N3MI-DG/StealthChanger/UserMods/N3MI-DG/SC_Barf/README.md

# Stealthchanger Barf

PCB with 1.5mm RGB leds arranged into the StealthChanger logo pattern.

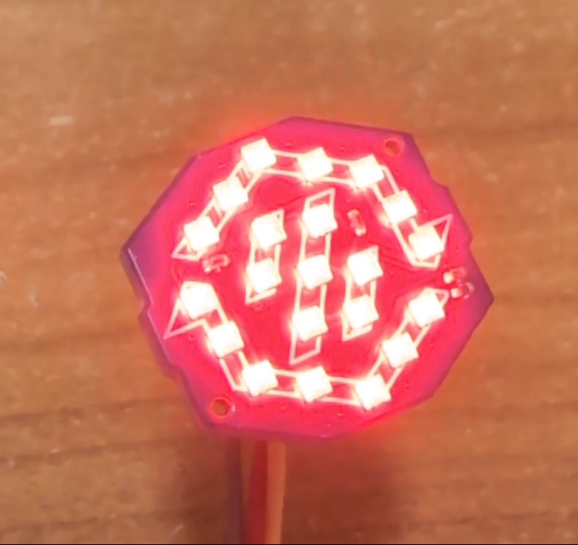
[picture p1: UserMods/N3MI-DG/SC_Barf/images/1.png]



## Example Config

```text
[neopixel rgb_logo]
pin: PB3
color_order: GRB
chain_count: 21
initial_RED: 0.3
initial_BLUE: 0.0
initial_GREEN: 0.3
```

## How to Order from JLCPCB

- Add Gerbers `Gerbers.zip`
- Select the PCB qty you want
- Select the PCB color you want
- Select `Order Number(Specify Position)`
- Enable PCB Assembly
- Select `Added by Customer` in the Tooling holes section
- Press the `Next` button
- Press the next `Next` button
- Add BOM file `BOM-JLC.csv`
- Add CPL file `CPL-JLC.csv`
- Click the `Process BOM & CPL` button
- Make sure the selected componants are correct
- Click the `Next` button
- Confirm componant placement
- Click the `Next` button
- Save to cart & checkout.

Note. there is an alternative RGB led componant that can be selected if the `SK6805-EC15` is out of stock. `DY-S1515065/RGBC/6805-5T` by TONYU is 1:1 compatible but the JLC footprint is rotated 180 degrees. Confirm you have the correct orientations.

### SK6805-EC15
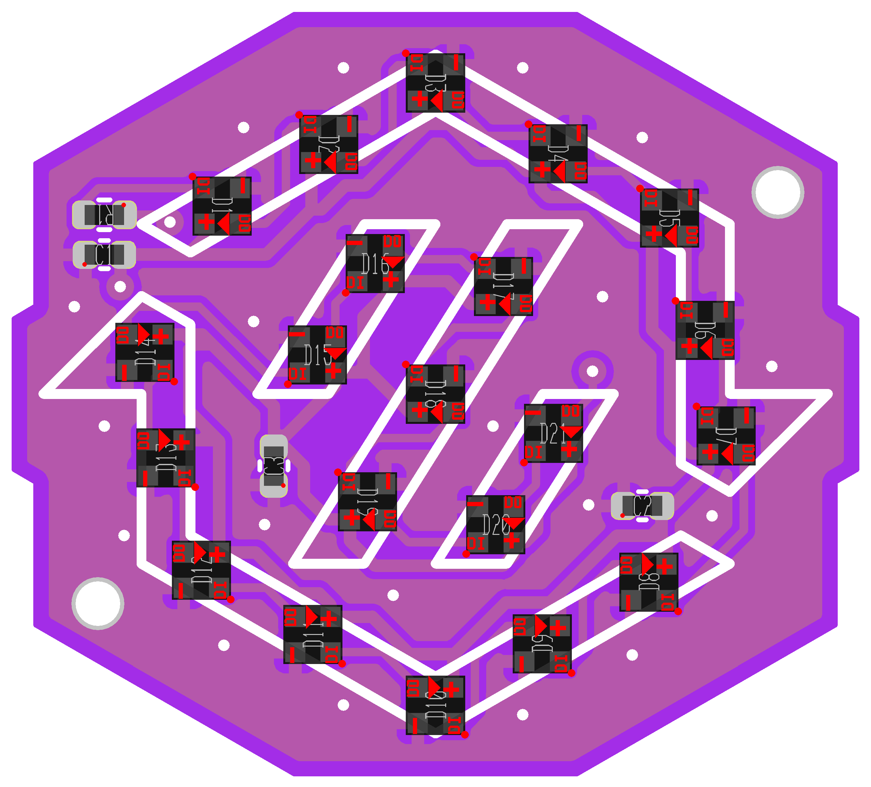
[picture p2: UserMods/N3MI-DG/SC_Barf/images/corrcet_placement.png]


### DY-S1515065/RGBC/6805-5T
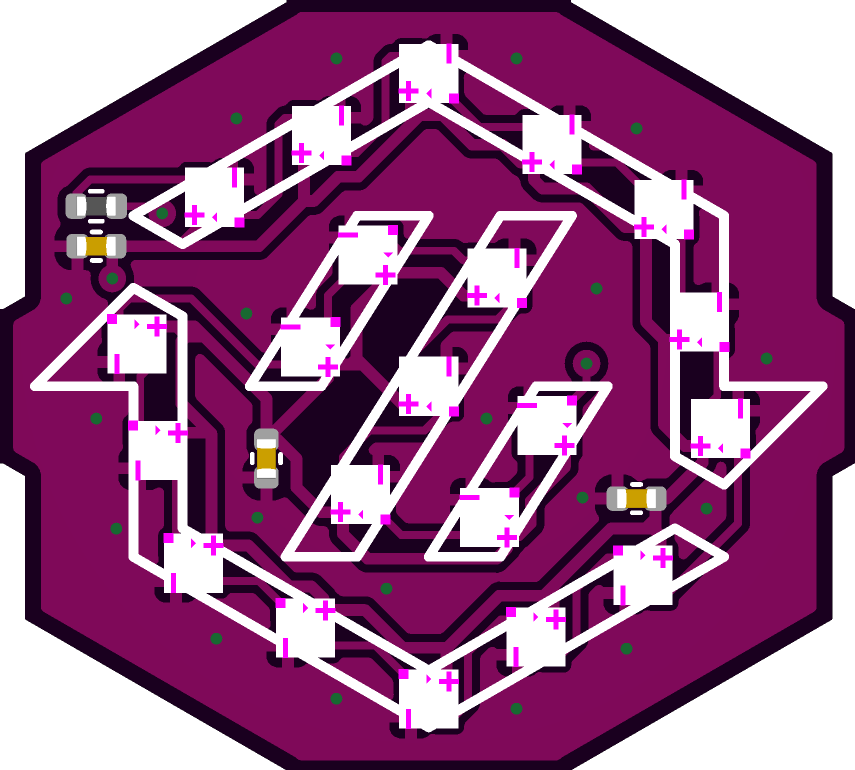
[picture p3: UserMods/N3MI-DG/SC_Barf/images/corrcet_placement_TONYU.png]


#### Disclaimer
This project is supplied as is. I am not responsable for any mishaps that may occur from the PCB ordering and manufacturing process. If you wish to manufacture and or sell these PCBs you may do so, but I do not, and will not endorse any such sales.
