N3MI-DG/StealthChanger/UserMods/N3MI-DG/Filament_Entry/STEP/Split/ecas_entry_3mm.step

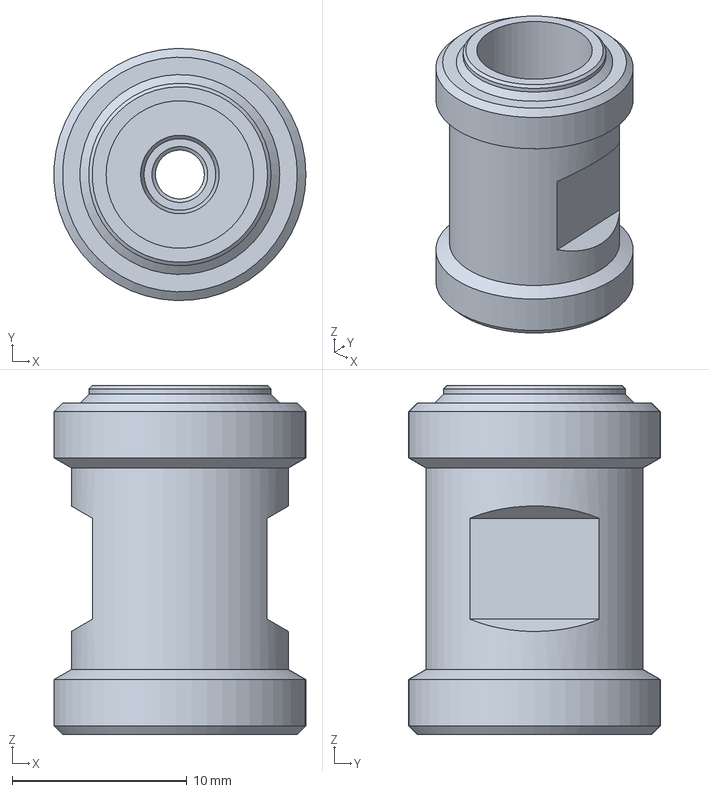
[picture p4: CAD file, 2024-07-25]
UserMods/N3MI-DG/Filament_Entry/STEP/Split/ecas_entry_3mm.step
14.4 x 14.4 x 20.0 mm
