N3MI-DG/StealthChanger/UserMods/N3MI-DG/SC_Barf/CAD/Puck.step

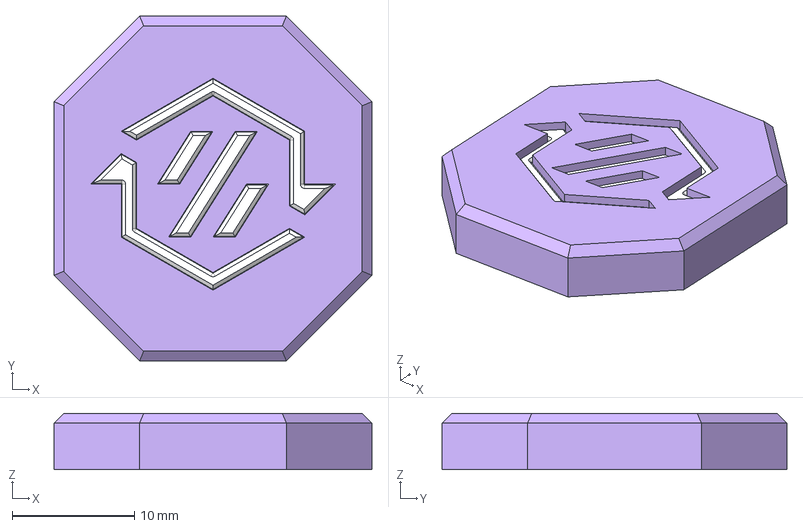
[picture p5: CAD file, 2024-10-04]
UserMods/N3MI-DG/SC_Barf/CAD/Puck.step
26.0 x 28.2 x 4.60 mm
Front_part
OPA_part
Document x 21
R_0402_1005Metric_1
C_0402_1005Metric_1 x 3
_autosave-SC_Logo_LED_PCB
