N3MI-DG/StealthChanger/UserMods/N3MI-DG/Sherpa_Micro_EBB36_Mount/STL/EBB36_Cover.stl

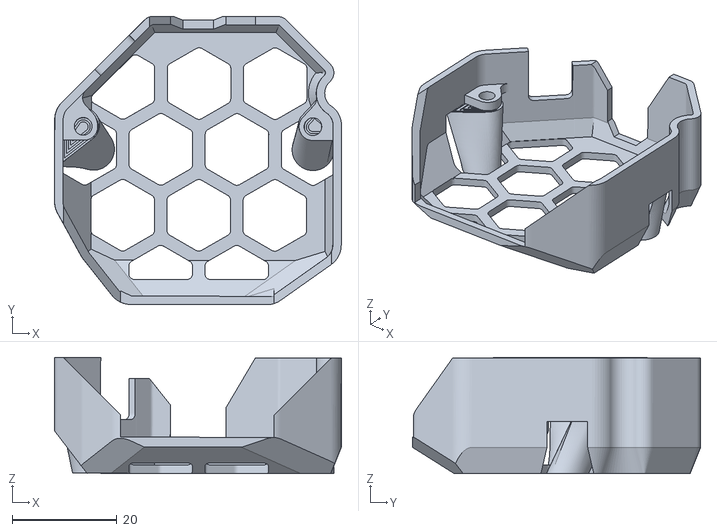
[picture p6: CAD file, 2024-10-04]
UserMods/N3MI-DG/Sherpa_Micro_EBB36_Mount/STL/EBB36_Cover.stl
54.8 x 55.1 x 22.2
