N3MI-DG/StealthChanger/UserMods/N3MI-DG/SC_Barf/CAD/PCB.step

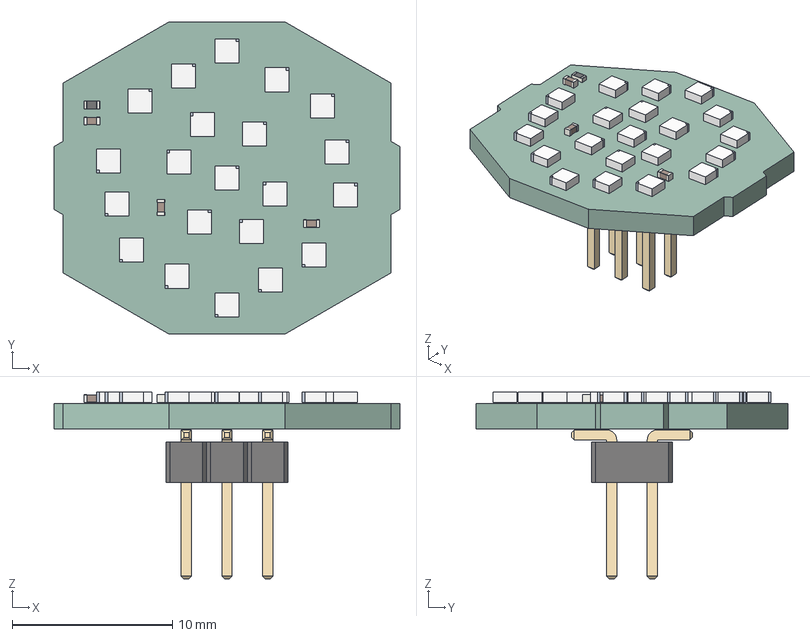
[picture p7: CAD file, 2024-10-04]
UserMods/N3MI-DG/SC_Barf/CAD/PCB.step
21.6 x 19.5 x 11.7 mm
Document x 21
R_0402_1005Metric
C_0402_1005Metric x 3
PinHeader_2x03_P254mm_Vertical_SMD
_autosave-SC_Logo_LED_PCB
