N3MI-DG/StealthChanger/(list of files, cad)

Other CAD files:
UserMods/N3MI-DG/Filament_Entry/STEP/Split/ecas_entry_2.5mm.step
UserMods/N3MI-DG/Filament_Entry/STL/Split/ecas_entry_2.5mm.stl
UserMods/N3MI-DG/Filament_Entry/STL/Split/ecas_entry_3mm.stl
