N3MI-DG/StealthChanger/UserMods/N3MI-DG/SC_Barf/KiCad/SC_Barf.kicad_pcb

## KiCad design UserMods/N3MI-DG/SC_Barf/KiCad/SC_Barf.kicad_pcb (2024-10-04)

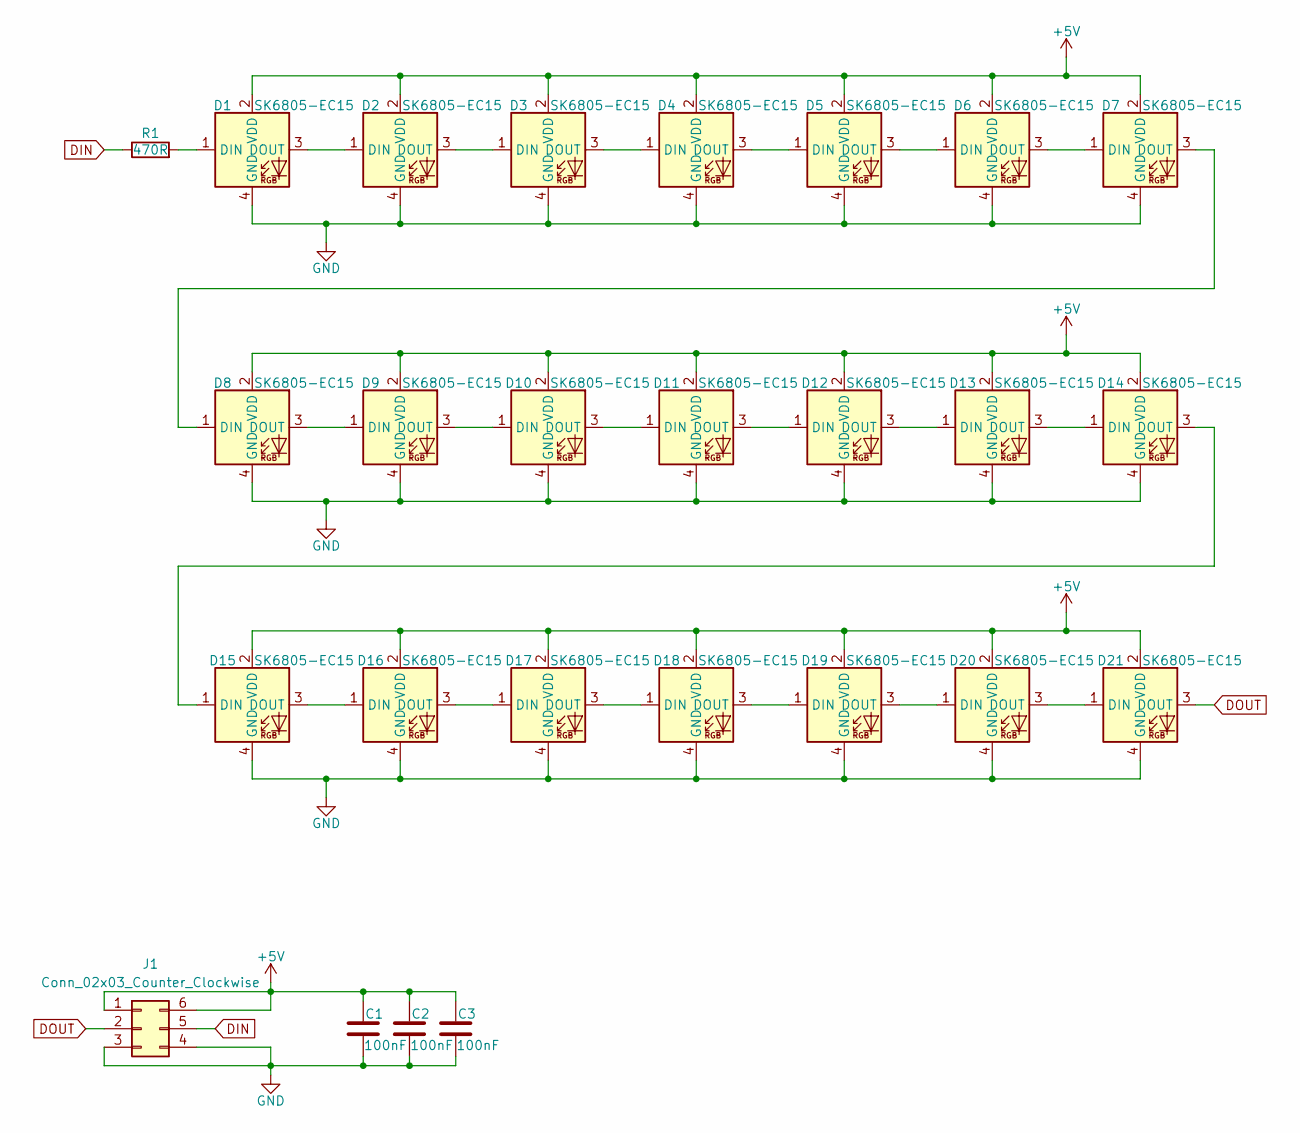
[picture p8: schematic SC_Barf.kicad_sch, SC Barf]

Parts:
C1, C2, C3: 100nF; C_0402_1005Metric; LCSC C14445
D1, D2, D3, D4, D5, D6, D7, D8, D9, D10, D11, D12, D13, D14, D15, D16, D17, D18, D19, D20, D21: SK6805-EC15; LCSC C2890035
J1: Conn_02x03_Counter_Clockwise; PinHeader_2x03_P2.54mm_Vertical_SMD
R1: 470R; R_0402_1005Metric; LCSC C25117

Connections:
Board_0-+5V: C1.2, C2.2, C3.2, D1.2 (VDD), D2.2 (VDD), D3.2 (VDD), D4.2 (VDD), D5.2 (VDD), D6.2 (VDD), D7.2 (VDD), D8.2 (VDD), D9.2 (VDD), D10.2 (VDD), D11.2 (VDD), D12.2 (VDD), D13.2 (VDD), D14.2 (VDD), D15.2 (VDD), D16.2 (VDD), D17.2 (VDD), D18.2 (VDD), D19.2 (VDD), D20.2 (VDD), D21.2 (VDD), J1.1, J1.6
Board_0-DIN: J1.5, R1.1
Board_0-DOUT: D21.3 (DOUT), J1.2
Board_0-GND: C1.1, C2.1, C3.1, D1.4 (GND), D2.4 (GND), D3.4 (GND), D4.4 (GND), D5.4 (GND), D6.4 (GND), D7.4 (GND), D8.4 (GND), D9.4 (GND), D10.4 (GND), D11.4 (GND), D12.4 (GND), D13.4 (GND), D14.4 (GND), D15.4 (GND), D16.4 (GND), D17.4 (GND), D18.4 (GND), D19.4 (GND), D20.4 (GND), D21.4 (GND), J1.3, J1.4
Board_0-Net-(D1-DIN): D1.1 (DIN), R1.2
Board_0-Net-(D1-DOUT): D1.3 (DOUT), D2.1 (DIN)
Board_0-Net-(D2-DOUT): D2.3 (DOUT), D3.1 (DIN)
Board_0-Net-(D3-DOUT): D3.3 (DOUT), D4.1 (DIN)
Board_0-Net-(D4-DOUT): D4.3 (DOUT), D5.1 (DIN)
Board_0-Net-(D5-DOUT): D5.3 (DOUT), D6.1 (DIN)
Board_0-Net-(D6-DOUT): D6.3 (DOUT), D7.1 (DIN)
Board_0-Net-(D7-DOUT): D7.3 (DOUT), D8.1 (DIN)
Board_0-Net-(D8-DOUT): D8.3 (DOUT), D9.1 (DIN)
Board_0-Net-(D10-DIN): D9.3 (DOUT), D10.1 (DIN)
Board_0-Net-(D10-DOUT): D10.3 (DOUT), D11.1 (DIN)
Board_0-Net-(D11-DOUT): D11.3 (DOUT), D12.1 (DIN)
Board_0-Net-(D12-DOUT): D12.3 (DOUT), D13.1 (DIN)
Board_0-Net-(D13-DOUT): D13.3 (DOUT), D14.1 (DIN)
Board_0-Net-(D14-DOUT): D14.3 (DOUT), D15.1 (DIN)
Board_0-Net-(D15-DOUT): D15.3 (DOUT), D16.1 (DIN)
Board_0-Net-(D16-DOUT): D16.3 (DOUT), D17.1 (DIN)
Board_0-Net-(D17-DOUT): D17.3 (DOUT), D18.1 (DIN)
Board_0-Net-(D18-DOUT): D18.3 (DOUT), D19.1 (DIN)
Board_0-Net-(D19-DOUT): D19.3 (DOUT), D20.1 (DIN)
Board_0-Net-(D20-DOUT): D20.3 (DOUT), D21.1 (DIN)

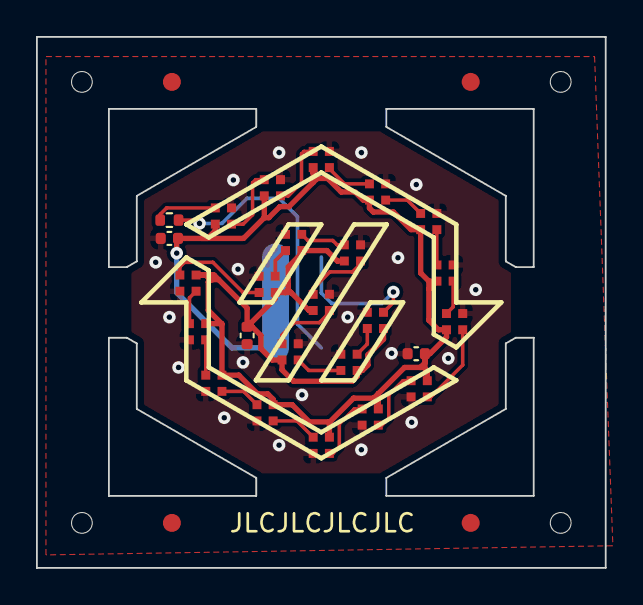
[picture p9: board SC_Barf.kicad_pcb from above]

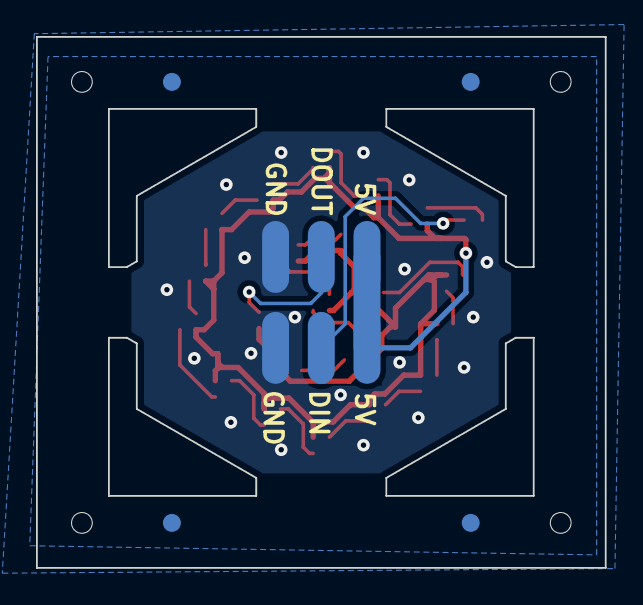
[picture p10: board SC_Barf.kicad_pcb from below]

Board: 2 copper layers, 31.6 x 29.5 mm, 38 parts (5 on the bottom side), 25 nets.

Other parts of the board:
KiKit_FID_B_1, KiKit_FID_B_2, KiKit_FID_B_3, KiKit_FID_B_4: Fiducial
KiKit_FID_T_1, KiKit_FID_T_2, KiKit_FID_T_3, KiKit_FID_T_4: Fiducial
KiKit_TO_1, KiKit_TO_2, KiKit_TO_3, KiKit_TO_4: NPTH
