N3MI-DG/StealthChanger/(commit log)

2024-07-25 Use correct ECAS04 files
    [ecas_entry_2.5mm.step, ecas_entry_2.5mm.stl, ecas_entry_3mm.step, ecas_entry_3mm.stl]
2024-10-04 Add more clearance to EBB36 cover
    [EBB36_Cover.stl]
